konkers/dmx2led/README.md

# dmx2led
DMX512 to Addressable RGB LED Converter
