konkers/dmx2led/pcb/dmx2led-pcb.kicad_pcb

## KiCad design pcb/dmx2led-pcb.kicad_pcb (2021-08-26)

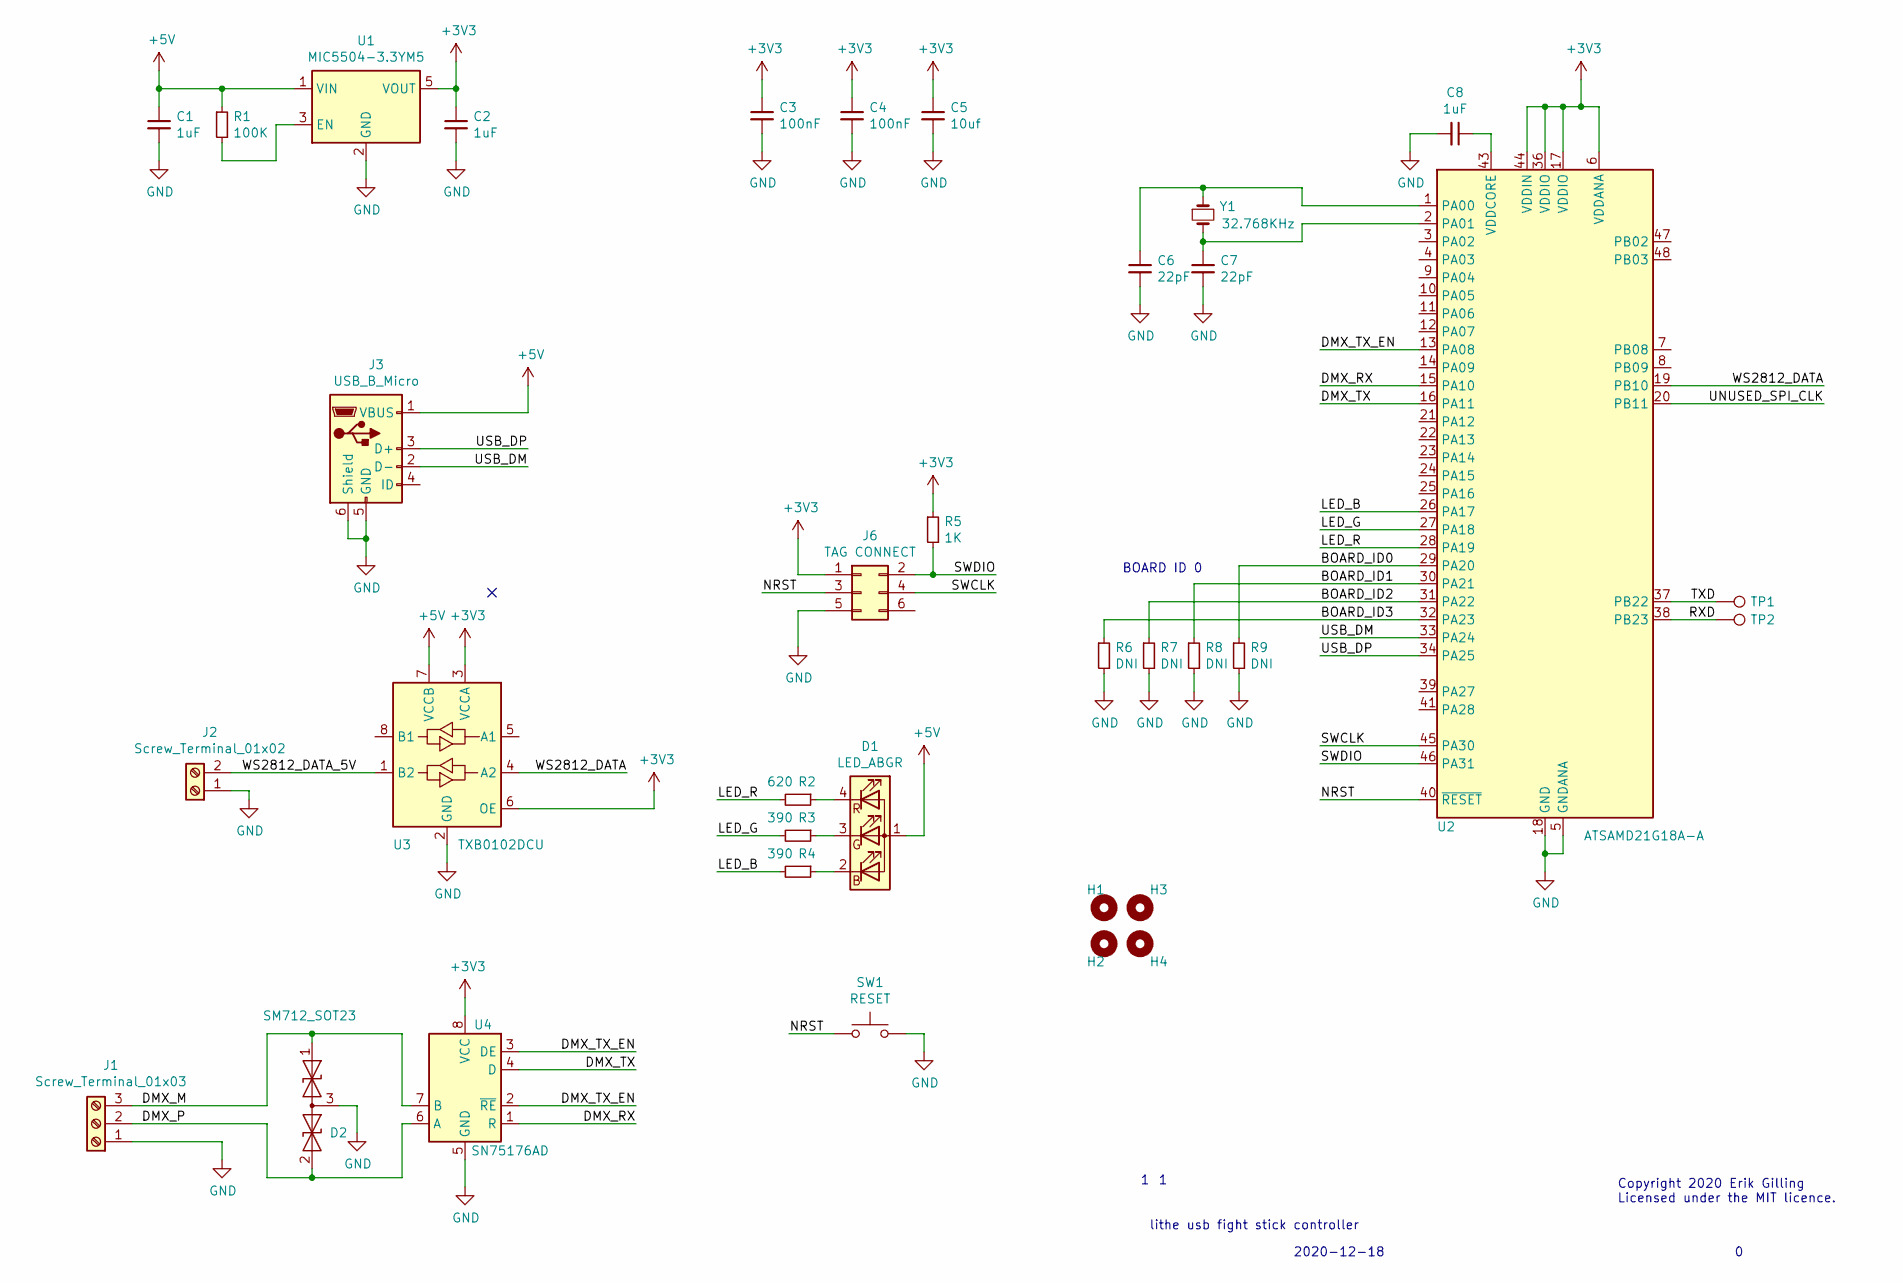
[picture p1: schematic dmx2led-pcb.sch]

Parts:
C1, C2, C8: 1uF; C_0402_1005Metric; DIGI_PN 1276-6524-2-ND
C3, C4: 100nF; C_0402_1005Metric; DIGI_PN 311-2077-1-ND
C5: 10uf; C_0603_1608Metric; DIGI_PN 490-3298-1-ND
C6, C7: 22pF; C_0402_1005Metric; DIGI_PN 445-1239-1-ND
D1: LED_ABGR; LED_Cree-PLCC4_2x2mm_CW; DIGI_PN CLMVC-FKA-CL1D1L71BB7C3C3TR-ND
D2: SM712_SOT23; SOT-23
H1, H2, H3, H4: MountingHole; MountingHole_3.2mm_M3_ISO7380
J1: Screw_Terminal_01x03; TerminalBlock_Phoenix_PT-1,5-3-3.5-H_1x03_P3.50mm_Horizontal
J2: Screw_Terminal_01x02; TerminalBlock_Phoenix_PT-1,5-2-3.5-H_1x02_P3.50mm_Horizontal
J3: USB_B_Micro; USB_Micro-B_Molex-105017-0001
J6: TAG CONNECT; Tag-Connect_TC2030-IDC-NL_2x03_P1.27mm_Vertical
R1: 100K; R_0402_1005Metric; DIGI_PN YAG2307TR-ND
R2: 620; R_0402_1005Metric; DIGI_PN 311-620LRTR-ND
R3, R4: 390; R_0402_1005Metric; DIGI_PN 311-390LRTR-ND
R5: 1K; R_0402_1005Metric; DIGI_PN 311-1.00KLRTR-ND
R6, R7, R8, R9: DNI; R_0402_1005Metric; DIGI_PN 311-0.0JRTR-ND
SW1: RESET; SW_SPST_EVQPE1; DIGI_PN CKN12311-2-ND
TP1, TP2: TestPoint; TestPoint_Pad_D1.0mm
U1: MIC5504-3.3YM5; SOT-23-5; DIGI_PN MIC5504-3.3YM5-T5TR-ND
U2: ATSAMD21G18A-A; TQFP-48_7x7mm_P0.5mm; DIGI_PN ATSAMD21G18A-AU-ND
U3: TXB0102DCU; VSSOP-8_2.4x2.1mm_P0.5mm
U4: SN75176AD; SOIC-8_3.9x4.9mm_P1.27mm
Y1: 32.768KHz; Crystal_SMD_MicroCrystal_CC7V-T1A-2Pin_3.2x1.5mm_HandSolder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; DIGI_PN 2195-CM7VT1ALOWESR32.768KHZ12.5PF20TAQC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

Connections:
+3V3: C2.1, C3.1, C4.1, C5.1, J6.1, R5.1, U1.5 (VOUT), U2.6 (VDDANA), U2.17 (VDDIO), U2.36 (VDDIO), U2.44 (VDDIN), U3.3 (VCCA), U3.6 (OE), U4.8 (VCC)
+5V: C1.1, D1.1 (A), J3.1 (VBUS), R1.1, U1.1 (VIN), U3.7 (VCCB)
/BOARD_ID0: R9.1, U2.29 (PA20)
/BOARD_ID1: R8.1, U2.30 (PA21)
/BOARD_ID2: R7.1, U2.31 (PA22)
/BOARD_ID3: R6.1, U2.32 (PA23)
/DMX_M: D2.1 (A1), J1.3, U4.7 (B)
/DMX_P: D2.2 (A2), J1.2, U4.6 (A)
/DMX_RX: U2.15 (PA10), U4.1 (R)
/DMX_TX: U2.16 (PA11), U4.4 (D)
/DMX_TX_EN: U2.13 (PA08), U4.2 (~RE), U4.3 (DE)
/LED_B: R4.2, U2.26 (PA17)
/LED_G: R3.2, U2.27 (PA18)
/LED_R: R2.2, U2.28 (PA19)
/NRST: J6.3, SW1.1, U2.40 (~RESET)
/RXD: TP2.1, U2.38 (PB23)
/SWCLK: J6.4, U2.45 (PA30)
/SWDIO: J6.2, R5.2, U2.46 (PA31)
/TXD: TP1.1, U2.37 (PB22)
/UNUSED_SPI_CLK: U2.20 (PB11)
/USB_DM: J3.2 (D-), U2.33 (PA24)
/USB_DP: J3.3 (D+), U2.34 (PA25)
/WS2812_DATA: U2.19 (PB10), U3.4 (A2)
/WS2812_DATA_5V: J2.2, U3.1 (B2)
GND: C1.2, C2.2, C3.2, C4.2, C5.2, C6.2, C7.2, C8.2, D2.3 (common), J1.1, J2.1, J3.5 (GND), J3.6 (Shield), J6.5, R6.2, R7.2, R8.2, R9.2, SW1.2, U1.2 (GND), U2.5 (GNDANA), U2.18 (GND), U2.35 (GND), U2.42 (GND), U3.2 (GND), U4.5 (GND)
unnamed: C6.1, U2.1 (PA00), Y1.1
unnamed: C7.1, U2.2 (PA01), Y1.2
unnamed: C8.1, U2.43 (VDDCORE)
unnamed: D1.2 (BK), R4.1
unnamed: D1.3 (GK), R3.1
unnamed: D1.4 (RK), R2.1
unnamed: R1.2, U1.3 (EN)

Notes on the sheet:
lithe usb fight stick controller
2020-12-18
Copyright 2020 Erik Gilling Licensed under the MIT licence.
BOARD ID 0

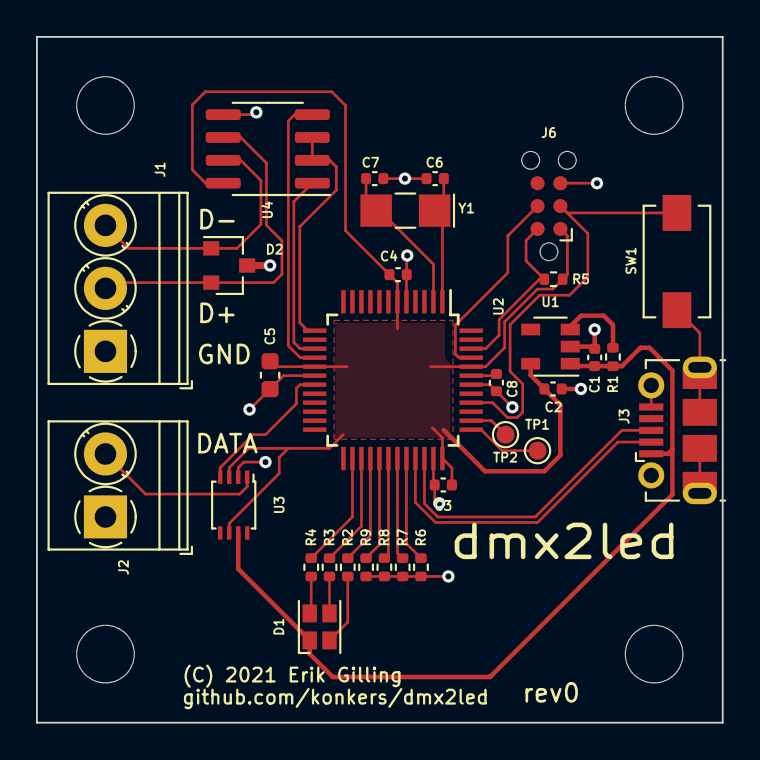
[picture p2: board dmx2led-pcb.kicad_pcb from above]

Board: 2 copper layers, 38.1 x 38.1 mm, 35 parts (0 on the bottom side), 31 nets.
