konkers/dmx2led/(commit log)

2021-08-26 Initial prototype firmware.
    DMX to WS2812b functional
2021-08-26 rev0 PCB
    [dmx2led-pcb.kicad_pcb, dmx2led-pcb.sch]
