konkers/dmx2led/(notices)

Notices in the files:
pcb/dmx2led-pcb.kicad_pcb:
(C) 2021 Erik Gilling
